pavanda13/Sunflower-Solar-Panel-Controller/assets/outdoor_2.png

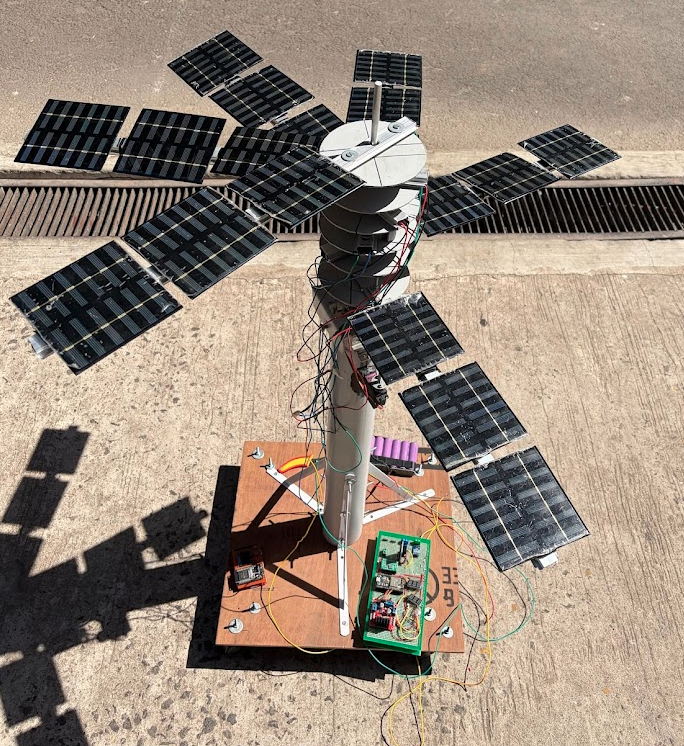
assets/outdoor_2.png
