pavanda13/Sunflower-Solar-Panel-Controller/assets/solar_sunflower_project_2.jpeg

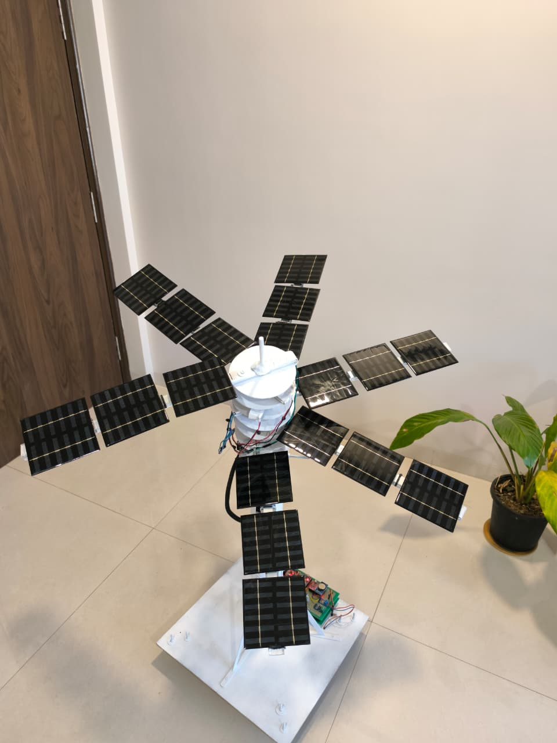
assets/solar_sunflower_project_2.jpeg
