pavanda13/Sunflower-Solar-Panel-Controller/Sunflower_Solar_Controller_Report.docx

SUNFLOWER SOLAR PANEL CONTROLLER

An Intelligent, Autonomous Solar Tracking & Monitoring System

Competition Presentation Report | April 2026

# 1. Introduction

The Sunflower Solar Panel Controller is a two-unit ESP32-based system that mimics the behaviour of a sunflower — deploying a solar panel at sunrise, tracking the sun throughout the day with a servo motor, and retracting the panel safely at sunset. A separate remote unit displays live sensor data on an OLED screen and allows the operator to manually override the servo and DC motor via four physical buttons, all over a private WiFi TCP connection that requires no internet infrastructure.

The project addresses a well-known problem in solar energy: fixed panels lose 25–40% of potential energy because they cannot follow the sun. Commercial solar trackers solve this but cost ₹40,000 or more per unit. This system achieves the same core functionality for under ₹2,500 in components, making professional-grade solar tracking accessible to small farmers, off-grid homes, and developing regions worldwide.

# 2. System Architecture

The system consists of two independent ESP32 microcontroller units that communicate over a private WiFi network using TCP sockets.

## 2.1 Solar Controller (Device 1)

Hardware components and GPIO assignments:

Component | Interface | GPIO Pins
L298N Motor Driver | Digital + PWM | IN1=18, IN2=16, ENA=17
Servo Motor (continuous) | PWM 50 Hz | GPIO 25
Panel Voltage Sensor | ADC | GPIO 34
Panel Current Sensor (ACS712) | ADC | GPIO 35
Battery Voltage Sensor | ADC | GPIO 32
RTC DS3231 | I²C | SDA=13, SCL=14

## 2.2 Remote Control Unit (Device 2)

The remote unit acts as a WiFi Access Point (192.168.4.1:5000). It hosts an OLED 128×64 dashboard showing live panel voltage, current, power, battery voltage, and the current time from the controller's RTC. Four buttons allow manual control:

Button | Command Sent | Command on Release | Effect
Button 1 | SERVO_FWD | SERVO_STOP | Hold to rotate servo forward
Button 2 | SERVO_REV | SERVO_STOP | Hold to rotate servo reverse
Button 3 | PANEL_OPEN | MOTOR_STOP | Hold to open panel manually
Button 4 | PANEL_CLOSE | MOTOR_STOP | Hold to close panel manually

# 3. Communication Protocol

## 3.1 Controller → Remote (every 100 ms)

CSV line over TCP:

HH:MM:SS , voltage , current , power , batteryVoltage

Example: 08:42:15 , 18.34 , 2.10 , 38.51 , 12.67

## 3.2 Remote → Controller (on button press/release)

Command | Trigger | Effect
SERVO_FWD | Hold button 1 | Servo rotates forward — manual sun tracking
SERVO_REV | Hold button 2 | Servo rotates reverse — undo tracking angle
SERVO_STOP | Release button 1 or 2 | Servo stops immediately
PANEL_OPEN | Hold button 3 | Motor opens panel (ignored if not IDLE)
PANEL_CLOSE | Hold button 4 | Motor closes panel (ignored if not IDLE)
MOTOR_STOP | Release button 3 or 4 | Motor stops immediately on release
RESET | Emergency command | Halts everything, clears all state flags

# 4. Key Technical Features

## 4.1 Non-Blocking Architecture

- Main loop runs every 10 ms — never uses delay(). All operations use millis() timers.
- Motor, servo, WiFi reconnect, and sensors all run concurrently without pausing each other.
- WiFi client.connect() is only attempted when motorState == MOTOR_IDLE to prevent blocking the PWM ramp (connect() can stall the CPU for up to 500ms).
- RTC is read over I²C every 1 second and cached — avoids 100× I²C overhead on every 10ms loop iteration.

## 4.2 Motor State Machine

- States: MOTOR_IDLE → MOTOR_OPENING / MOTOR_CLOSING / MOTOR_MANUAL → MOTOR_IDLE
- New commands (schedule or manual) are only accepted when motorState == MOTOR_IDLE, preventing double-trigger.
- The opened/closed flags are set after the motor physically finishes its run — not when the command fires — reflecting real-world panel position.
- Emergency RESET instantly calls hardBrake(), sets motorState = MOTOR_IDLE, and clears all timing variables.

## 4.3 PWM Soft-Ramp Motor Control

- Custom MotorL298N library ramps PWM from 0% → 100% over approximately 5 seconds (1% per 50ms by default).
- A 30% kickstart pulse is applied immediately on setSpeed() to overcome static friction before ramping.
- hardBrake() instantly cuts all PWM and direction pins — used for emergency RESET.
- Smooth ramp significantly reduces mechanical shock, extending the life of the gearbox, belt, and panel mounting hardware.

## 4.4 Automatic Current Sensor Calibration

- On every boot, 500 ADC samples are averaged over 1 second with no load connected.
- The resulting mean voltage is stored as ACS_OFFSET — the zero-current reference.
- This eliminates offset drift caused by temperature changes and supply voltage variation.
- No manual potentiometer or trim adjustment is required — the system self-configures each startup.

## 4.5 Servo Sun Tracking

- Auto-tracking fires every 15 minutes while the panel is open (configurable via SERVO_TRACK_INTERVAL).
- Duration is mathematically calculated from SERVO_RPM and SERVO_TRACK_REVS — not guessed.
- Priority order: Manual command > Auto-track > Stop. Manual override pauses auto-tracking instantly.
- Auto-tracking is cancelled immediately when the panel closes at end of day.

# 5. Large Scale Implementation

## 5.1 Hardware Scaling

- Replace the single ESP32 controller with a Raspberry Pi or industrial PLC as a central hub managing hundreds of panel units over a network.
- The L298N motor driver is replaced with 3-phase motor controllers for the larger DC or AC actuators used in commercial trackers.
- Stepper motors with quadrature encoders replace the continuous-rotation servo, providing precise angular position control and eliminating open-loop drift.
- Industrial-grade CT clamps rated for 100A+ replace the ACS712 modules for high-current installations.
- The OLED display is replaced by a web-based Grafana or React dashboard showing fleet-wide metrics on a map, with per-panel status indicators.
- Dual-axis tracking: a second motor added for elevation angle control increases annual yield by a further 10–15% beyond single-axis.

## 5.2 Network and Software Scaling

- Replace direct TCP with an MQTT broker (Mosquitto). Each panel publishes sensor data to its own topic; a central server subscribes to all topics simultaneously.
- OTA (Over-the-Air) firmware updates push new code to all panels in a field without physical access to each unit.
- Time-series database (InfluxDB or TimescaleDB) stores all sensor readings for historical analysis, fault detection, and energy yield reporting.
- A REST API allows any monitoring tool (mobile app, web browser, SCADA system) to query panel status, issue commands, and update schedules.
- GPS-based sun angle calculation using the NOAA solar position algorithm computes optimal panel angle from latitude, longitude, and UTC time — eliminating the fixed 15-minute interval assumption.
- Cloud backup with automated daily energy yield reports delivered via email or SMS to the owner.

## 5.3 Physical Deployment

- Panels mounted on single-axis tracker rails (east-west rotation) driven by the DC motor — the most common commercial solar tracker design.
- Wind speed sensor auto-retracts all panels when gusts exceed a configurable safe threshold, preventing storm damage.
- IP65-rated weatherproof enclosures for all electronics with cable glands; surge protection and reverse-polarity protection on all power inputs.
- Modular wiring harness — each panel unit is identical and plug-and-play, reducing installation time and training requirements.
- Staggered motor start schedules prevent current surges when all 100+ panels attempt to open simultaneously at sunrise.

# 6. System Improvements

## 6.1 Precision Sun Tracking

- Add an LDR (light-dependent resistor) differential pair — the servo rotates until both sensors read equal illumination, meaning the panel is facing the sun directly. Replaces the open-loop timed pulse.
- Closed-loop position control: rotary encoder on the servo shaft confirms actual angular position and enables the controller to command precise angles rather than timed rotations.
- MPPT algorithm (Maximum Power Point Tracking): continuously adjust panel angle to maximise real-time power output, not just geometric alignment with the sun. Accounts for cloud diffusion and partial shading.
- Add an elevation axis motor for full 2-axis tracking — adds 10–15% annual energy yield over single-axis alone.

## 6.2 Reliability and Safety

- Motor stall detection: add a dedicated current sensor on the motor supply line. A current spike without movement triggers an immediate halt and fault alert.
- Panel position encoder: know the exact open angle at all times. Prevents over-driving the motor if the panel is mechanically obstructed.
- ESP32 hardware watchdog timer: auto-reboots the system if the firmware hangs, ensuring the panel is never left in an unknown state.
- Redundant time source: sync from NTP when WiFi is available; fall back to DS3231 RTC when offline. RTC drift corrected automatically after each NTP sync.
- Surge protection and TVS diodes on all ADC input lines to prevent sensor damage from lightning or motor back-EMF.

## 6.3 Energy Intelligence

- State-of-charge calculation: derive battery percentage from the discharge voltage curve rather than relying on raw voltage alone.
- Watt-hour accumulation: log daily energy yield (kWh) to flash memory for comparison against historical and predicted values.
- Low battery protection: automatically retract the panel and enter sleep mode when battery voltage drops critically low, protecting the battery from deep discharge.
- Efficiency monitoring: compare actual yield to expected yield based on solar irradiance models; alert when efficiency drops more than 10% below threshold (indicating soiling or shading).
- Panel temperature sensor: derate power estimate on hot days (approximately 0.3% per °C above 25°C for silicon cells).

## 6.4 User Interface

- Replace the OLED with a colour TFT touchscreen showing scrollable voltage, current, and power graphs with time-axis.
- Mobile app via Bluetooth or WiFi for configuration: set open/close times, tracking interval, and RPM calibration without touching firmware.
- Push notifications when power drops below expected threshold or a fault is detected — delivered via SMS, WhatsApp, or email.
- Web interface with historical charts, exportable CSV data, and remote schedule configuration accessible from any browser.
- Voice alerts via a small buzzer: distinct tones for open complete, close complete, and fault events.

# 7. Future Benefits and Applications

## 7.1 Energy Independence

- Single-axis tracking increases annual energy yield by 25–40% over a fixed panel installation.
- Adding a second (elevation) axis increases yield by a further 10–15%, for a total gain of up to 55% over fixed.
- More energy from the same number of panels reduces the total hardware cost and land area required for a given power target.
- Longer battery cycle life: the tracker maximises energy extraction during peak sun hours, reducing the number of days the battery must supply energy without solar recharge.

## 7.2 Agrivoltaics (Agriculture + Solar)

- Tilted solar panels allow morning and evening light to reach crops underneath while blocking harsh midday sun.
- Crops grown under tracked panels benefit from reduced heat stress, with studies showing up to 60% less water consumption in some climates.
- Dual income stream: farmers generate and sell electricity while continuing to grow crops on the same land.
- This system's automated tilt angle control makes it a ready-to-use foundation for agrivoltaic installations at the village level.

## 7.3 Smart Grid Integration

- Real-time power data at 100ms resolution feeds directly into grid balancing and demand-response systems.
- When panels report surplus generation, smart switches can automatically divert energy to water heating, EV charging, or grid export.
- Predictive generation forecasting: historical tracking data combined with weather APIs helps grid operators plan backup generation capacity.
- Micro-grid: a cluster of these units with a shared battery bank can power an entire village with automatic load balancing.

## 7.4 Developing World and Disaster Relief

- No internet required — the two ESP32s form their own private WiFi network, deployable in remote areas with zero infrastructure.
- Total BOM cost under ₹2,500 (~$30) makes professional solar tracking accessible to smallholder farmers globally.
- Can be assembled with basic tools and locally available modules — no specialist manufacturing required.
- Portable solar tracker + battery provides uninterrupted power for medical equipment, water pumps, and communications in disaster zones.

## 7.5 Environmental Impact

Scale | Daily Energy Gain vs Fixed | Annual CO₂ Offset
1 rooftop panel (300W) | +~100 Wh/day | ~15 kg CO₂/year
100-panel farm (30 kW) | +~10 kWh/day | ~1,500 kg CO₂/year
Utility-scale (1 MW) | +~350 kWh/day | ~50,000 kg CO₂/year

Based on 35% improvement from single-axis tracking, 300 sunny days/year, and 0.4 kg CO₂/kWh grid average (IEA 2024).

# 8. Competitive Advantages

No Internet Required: The private WiFi network between the two ESP32s works in fields, deserts, and rooftops without any infrastructure. Unlike cloud-dependent systems, it cannot be disrupted by a server outage.

Custom PWM Motor Library: Soft-ramp 0→90% over 5 seconds with kickstart prevents gear shock, motor burnout, and belt snap. No commercial tracker at this price offers configurable ramp control.

Self-Calibrating Sensors: ACS712 zero offset auto-calibrated on every boot with 500 samples — compensates for temperature drift and eliminates manual potentiometer tuning.

State-Machine Safety: Motor only accepts new commands when IDLE. Flags reflect physical panel state, not command state. Single RESET halts everything to a known safe state.

100ms Live Data Stream: 10 readings per second is sufficient to detect transient shadows, partial shading, and wiring faults — far beyond the 1-second resolution of most hobby systems.

Extensible Protocol: Adding a new remote command requires one line in the buttons[] array. No other code changes needed — engineers can extend the system in minutes.

Under ₹2,500 Total Cost: Commercial solar trackers start at ₹40,000+. This system delivers the core functionality for 94% less, making it viable for mass deployment in developing markets.

# 9. Bill of Materials

Component | Qty | Unit Price | Total | Purpose
ESP32 Dev Board | 2 | ₹400 | ₹800 | Controller + Remote unit
L298N Motor Driver | 1 | ₹150 | ₹150 | DC motor control
DC Gear Motor (12V) | 1 | ₹350 | ₹350 | Panel open/close
Continuous Rotation Servo | 1 | ₹280 | ₹280 | Sun tracking
ACS712-30A Current Sensor | 1 | ₹120 | ₹120 | Panel current
Voltage Divider Module | 2 | ₹45 | ₹90 | Panel + battery voltage
DS3231 RTC Module | 1 | ₹180 | ₹180 | Schedule timekeeping
SSD1306 OLED 128×64 | 1 | ₹220 | ₹220 | Live dashboard display
Push Buttons (pack) | 1 | ₹50 | ₹50 | Manual control buttons
Misc (wires, PCB) | 1 | ₹200 | ₹200 | Wiring and prototyping
TOTAL | | | ₹2,440

# 10. Conclusion

The Sunflower Solar Panel Controller demonstrates that intelligent, autonomous solar tracking is not a luxury reserved for large utility companies. With under ₹2,500 of components and carefully engineered firmware, it is possible to build a system that:

- Increases annual solar energy yield by 25–40% through automated sun tracking.
- Monitors real-time panel voltage, current, and power at 100ms resolution.
- Provides a wireless OLED dashboard with live data and manual override — no internet required.
- Uses a robust state-machine architecture that is safe, non-blocking, and extensible.
- Scales directly to large solar farms via MQTT, cloud databases, and OTA firmware updates.
- Saves up to 50,000 kg of CO₂ per year per MW of solar capacity compared to fixed installations.

"The future of solar is not just bigger panels — it is smarter panels that follow the sun, report their health, and respond to their environment automatically."
