pavanda13/Sunflower-Solar-Panel-Controller/Sunflower_Solar_Controller_Presentation.pptx

SUNFLOWER

Solar Panel Controller

An Intelligent, Autonomous Solar Tracking & Monitoring System

Competition Presentation | April 2026

ESP32 • L298N Motor • Servo • RTC • WiFi TCP • OLED

## Slide 2

THE PROBLEM

Why fixed solar panels are not enough

25 – 40%

Energy Lost

Fixed panels miss peak sun because they cannot track the sun's movement across the sky. A panel pointed east loses hours of afternoon output.

Manual Only

No Automation

Repositioning panels by hand is impractical, especially on rooftops, remote farms, or large-scale solar fields with hundreds of panels.

Zero Visibility

No Monitoring

Most DIY systems have no way to know current power output, battery health, or whether the system is working — until something fails.

Weather Damage

No Protection

Panels left fully exposed during storms, hail, or high wind events are at risk of physical damage. Automated retraction prevents this.

High Cost

Barrier to Entry

Commercial solar trackers cost thousands of dollars, making them inaccessible for small farms, rural homes, and developing regions.

No Remote View

Operator Blind

Installers and owners have no remote dashboard to see live voltage, current, and power — making fault diagnosis slow and expensive.

Our system solves all six problems with a single $30 device.

## Slide 3

WHAT THE SYSTEM DOES

Inspired by the sunflower — follows the sun from dawn to dusk

OPEN

Opens panel at sunrise

RTC-scheduled DC motor fires at programmed morning time, physically deploying the solar panel to face the sky.

TRACK

Tracks sun every 15 minutes

Continuous-rotation servo rotates the panel angle toward the sun at 15-minute intervals throughout the day.

CLOSE

Closes panel at sunset

Motor reverses at programmed evening time, retracting the panel to protect it from wind, rain, and vandalism overnight.

MONITOR

Monitors output live

ACS712 current sensor + voltage dividers measure panel voltage (V), current (A), and calculated power (W) every 100 ms.

DISPLAY

Wireless OLED dashboard

A separate ESP32 shows live sensor values on an OLED screen over a private WiFi network — no internet required.

OVERRIDE

Manual control anytime

4 physical buttons let the operator manually open/close the panel or nudge the servo angle at any time.

RESET

Emergency stop

A single RESET command instantly halts motor and servo, clears all state flags — safe for field use.

CALIBRATE

Auto sensor calibration

On every boot, 500 ADC samples are averaged to auto-calibrate the zero-current offset — no manual tuning needed.

## Slide 4

SYSTEM ARCHITECTURE

Two ESP32 units — fully wireless, no internet required

Solar Controller (ESP32 — Client)

▶ L298N DC Motor Driver
▶ Continuous Rotation Servo
▶ Panel Voltage Sensor (GPIO 34)
▶ Panel Current Sensor ACS712 (GPIO 35)
▶ Battery Voltage Sensor (GPIO 32)
▶ RTC DS3231 — I²C timekeeping
▶ WiFi Station mode — TCP client
▶ Non-blocking 10ms loop
▶ PWM soft-ramp motor control
▶ Auto current sensor calibration

Remote Control Unit (ESP32 — AP)

▶ WiFi Access Point (192.168.4.1:5000)
▶ OLED 128×64 live dashboard
▶ Displays: Panel V, Current A, Power W
▶ Displays: Battery V, Time (HH:MM:SS)
▶ Button 1 — SERVO_FWD (hold to run)
▶ Button 2 — SERVO_REV (hold to run)
▶ Button 3 — PANEL_OPEN (hold to run)
▶ Button 4 — PANEL_CLOSE (hold to run)
▶ Auto-reconnects dropped clients
▶ Display refresh every 500ms

◄

WiFi TCP

►

Sensor CSV (100ms)

Button Commands

## Slide 5

KEY TECHNICAL FEATURES

Engineering decisions that make the system reliable in the field

Non-Blocking Architecture

• Main loop runs every 10 ms — never uses delay()
• All operations use millis() timers (motor, servo, WiFi, sensors)
• Motor, servo and WiFi reconnect all run concurrently without pausing each other
• WiFi connect() is only called when motor is IDLE to prevent blocking the PWM ramp

Motor State Machine

• States: MOTOR_IDLE → OPENING / CLOSING / MANUAL → IDLE
• New commands only accepted when state is MOTOR_IDLE — prevents double-trigger
• opened/closed flags set AFTER motor physically finishes — reflects real world
• Emergency RESET command instantly halts motor, servo, and clears all flags

PWM Soft-Ramp Control

• Custom MotorL298N library ramps 0→90% over ~5 seconds
• 30% kickstart PWM prevents stall against static friction on startup
• hardBrake() instantly cuts all PWM — used during RESET
• Smooth ramp reduces mechanical shock, extends belt and gear life significantly

Automatic Sensor Calibration

• ACS712 zero-current offset auto-calibrated on every boot
• Averages 500 ADC samples over 1 second before accepting load
• Eliminates offset drift from temperature and supply voltage variation
• No manual potentiometer tuning required — works out of the box

Servo Sun Tracking

• Auto-tracking fires every 15 minutes while panel is open
• Duration calculated from RPM and revolutions (not guessed)
• Manual override has highest priority — auto-track pauses instantly
• Tracking cancelled automatically when panel closes at end of day

Data Transmission

• CSV sent over TCP every 100 ms: time, V, A, W, battery V
• RTC cached every 1 second — avoids I²C overhead every 10 ms loop
• WiFi auto-reconnects every 5 seconds if connection drops
• Button press edge-detected with 200 ms debounce; release is immediate

## Slide 6

COMMUNICATION PROTOCOL

Private WiFi — TCP — no cloud, no internet, no latency

Controller → Remote (every 100 ms)

Format: HH:MM:SS , voltage , current , power , batteryVoltage

Example: 08:42:15 , 18.34 , 2.10 , 38.51 , 12.67

Field

Unit

Source

HH:MM:SS

voltage

Time

V

DS3231 RTC

Panel voltage divider GPIO 34

current

power

A

W

ACS712 current sensor GPIO 35

Calculated: voltage × current

Remote → Controller (on button press/release)

batteryVoltage

V

Battery voltage divider GPIO 32

Command

SERVO_FWD

Trigger

Hold button 1

Effect

Servo rotates forward — manual sun tracking

SERVO_REV

SERVO_STOP

Hold button 2

Release button 1 or 2

Servo rotates reverse — undo tracking angle

Servo stops immediately on release

PANEL_OPEN

PANEL_CLOSE

MOTOR_STOP

Hold button 3

Hold button 4

Release button 3 or 4

DC motor opens panel (only if MOTOR_IDLE)

DC motor closes panel (only if MOTOR_IDLE)

Motor stops immediately on release

RESET

Emergency

Halts everything, clears all state flags

## Slide 7

LARGE SCALE IMPLEMENTATION

How this prototype scales to a commercial solar farm

Hardware Scaling

• Replace ESP32 with Raspberry Pi / industrial PLC as central hub
• L298N → 3-phase motor controllers for larger actuators
• Single servo → stepper motors with encoders for precise angular control
• Voltage dividers → industrial CT clamps rated for high currents (100A+)
• OLED → web-based Grafana/React dashboard for fleet-wide metrics
• Add dual-axis trackers: separate motor for elevation angle control

Network & Software Scaling

• Replace direct TCP with MQTT broker (Mosquitto) — each panel is a topic
• OTA (Over-the-Air) firmware updates across entire field without physical access
• Time-series database (InfluxDB / TimescaleDB) for historical analysis
• REST API so any device (phone, browser, SCADA) can query panel status
• GPS-based sun angle calculation from latitude/longitude using NOAA formulas
• Cloud backup with daily energy yield reports sent via email/SMS

Physical Deployment

• Single-axis tracker (east-west) driven by DC motor — most common commercial design
• Dual-axis tracker adds elevation control for maximum annual yield
• Wind speed sensor auto-retracts all panels when gusts exceed safe threshold
• IP65 weatherproof enclosures for all electronics; surge protection on sensors
• Modular wiring harness — each panel unit is identical, plug-and-play
• Remote diagnostic port: plug in laptop to pull logs without disassembly

Operations at Scale

• Central dashboard shows all panels on a map — green/amber/red status
• Predictive maintenance: compare daily yield to expected yield, flag underperformers
• Automated fault detection: if panel V drops unexpectedly, send SMS alert
• Staggered motor schedules to avoid current surge when 100 panels open at once
• Role-based access: operators can view, admins can reconfigure schedules
• Audit log of all commands and state changes for insurance and warranty claims

## Slide 8

SYSTEM IMPROVEMENTS

Upgrades to transform the prototype into a production-grade system

Precision Sun Tracking

• Add LDR (light-dependent resistor) pair — servo stops when both read equal light
• Closed-loop: encoder on servo shaft confirms actual angular position
• MPPT algorithm — track angle that maximises real-time power, not just sun direction
• Add elevation axis motor for full 2-axis tracking (+15% extra yield over single axis)
• Store tracking history to learn seasonal patterns and anticipate sun position

Reliability & Safety

• Motor stall detection — dedicated current sensor on motor supply line
• Panel position encoder — know exact open angle, prevent over-driving
• ESP32 hardware watchdog — auto-reboot if firmware hangs
• Redundant NTP time sync when WiFi is available; RTC as offline fallback
• Surge protection and reverse-polarity protection on all power inputs

Energy Intelligence

• State-of-charge calculation from battery voltage discharge curve
• Watt-hour accumulation — log daily energy yield (kWh) to flash memory
• Low battery alert — automatically retract panel and go to sleep mode
• Compare actual vs expected yield — alert if efficiency drops below threshold
• Temperature sensor on panel — derate power estimate on hot days (3% per °C)

User Interface

• Replace OLED with colour TFT touchscreen showing voltage/current/power graphs
• Mobile app via Bluetooth for configuration (set open/close times, tracking interval)
• Push notifications when power drops below expected or a fault is detected
• Voice alerts via small buzzer — different tones for open, close, fault events
• Web interface with historical charts, exportable CSV, and remote schedule config

Connectivity

• MQTT over WiFi to a local home server or cloud broker (AWS IoT / HiveMQ)
• LoRa radio fallback for installations beyond WiFi range (up to 10km line-of-sight)
• 4G LTE module option for completely off-grid sites with no WiFi infrastructure
• Mesh networking — controllers relay data through each other to the gateway
• Encrypted TLS communication to prevent command injection over the air

Manufacturing & Deployment

• Custom PCB to replace breadboard wiring — reduces failure points significantly
• Conformal coating on PCB for humidity and corrosion resistance
• 3D-printed weatherproof enclosure with cable glands and DIN rail mount
• Factory calibration routine — automated test jig checks each unit before shipping
• QR code on each unit links to its data dashboard and service history

## Slide 9

FUTURE BENEFITS & APPLICATIONS

Why this technology matters beyond the competition

Energy Independence

• Single-axis tracker increases annual yield by 25–40% over fixed panels
• Dual-axis tracking adds a further 10–15% on top of single-axis
• Fewer panels needed for the same power target — lower land and material cost
• Longer battery cycle life: tracker extracts full energy during peak sun hours
• Enables off-grid homes, farms, and villages to become energy self-sufficient

Agricultural (Agrivoltaics)

• Tilted panels let morning/evening light through while blocking harsh midday sun
• Crops grown underneath benefit from shade — up to 60% less water consumption
• Dual income: farmers sell electricity AND grow crops on the same land
• This system’s tilt angle control makes it a ready foundation for agrivoltaics
• Already deployed at scale in Japan, Germany, and South Korea

Smart Grid Integration

• Real-time power data at 100ms resolution feeds directly into grid balancing
• When panels report excess generation, smart switches divert energy to EV charging
• Demand-response: utilities can remotely schedule open/close times to shift load
• Micro-grid: cluster of these units can power a village with automatic load sharing
• Predictive generation forecast helps grid operators plan backup generation

Developing World & Disaster Relief

• No internet required — the two ESP32s form their own private WiFi network
• Total BOM cost under ₹2500 (∼$30) — accessible to smallholder farmers globally
• Can be assembled with basic tools and locally available components
• Solar tracker + battery means uninterrupted power even in remote locations
• Deployed to disaster zones as portable power stations for medical equipment

Environmental Impact

• Every 1% yield improvement = proportionally fewer panels for a given power target
• Fewer panels = less silicon, aluminium, and rare earth mining required
• 1 MW solar farm with tracking: +350 kWh/day = saves ~50,000 kg CO₂/year
• Retractable panels survive hailstorms — longer panel life, less e-waste
• Closed-loop MPPT maximises green energy extraction without any fuel burning

Commercial & Research Opportunities

• Platform for AI-based sun prediction using historical tracking data
• University research tool for studying panel degradation and soiling effects
• Integration with weather APIs to pre-position panels before storms arrive
• Data marketplace: anonymised energy yield data valuable to grid planners
• White-label product for solar installation companies to brand and resell

## Slide 10

REAL-WORLD IMPACT

Quantified energy gains from single-axis solar tracking

+35%

Average annual energy gain
from single-axis tracking
vs fixed panel

+50%

Peak-hour energy gain
on clear summer days

100ms

Sensor data refresh rate
— real-time monitoring
for every panel

₹2500

Total Bill of Materials
cost for the complete
two-unit system

15 min

Sun tracking interval
— optimal balance of
yield vs servo wear

50,000 kg

CO₂ saved per year
for a 1 MW farm
using this tracker

Based on 35% improvement from single-axis tracking, 300 sunny days/year, 0.4 kg CO₂/kWh grid average (IEA 2024)

## Slide 11

COMPETITIVE ADVANTAGES

What makes this system stand out

No Internet Required

The two ESP32s form a private WiFi network. Works in fields, deserts, rooftops — anywhere with no infrastructure. Unlike cloud-dependent systems, it cannot be killed by a server outage.

Custom PWM Motor Library

Soft-ramp 0→90% over 5 seconds with kickstart — prevents gear shock, motor burnout, and belt snap. No commercial tracker at this price point offers configurable ramp control.

01

02

Self-Calibrating Sensors

ACS712 zero offset auto-calibrated on every boot with 500 samples. Eliminates manual potentiometer tuning and compensates for temperature drift automatically over the lifetime of the unit.

03

State-Machine Safety

Motor only accepts a new command when IDLE — impossible to trigger opening while already opening. Flags are set after physical completion, not on command issue, reflecting real-world state.

04

100ms Live Data Stream

10 readings per second over TCP gives a smooth, real-time view of voltage, current, and power. Enough resolution to detect transient shadows, partial shading, and wiring faults.

05

Extensible Command Protocol

Adding a new button or remote command requires one line in the buttons[] array — no other code changes. Engineers can add features in minutes without understanding the full codebase.

06

Emergency Reset

A single RESET command stops motor, stops servo, clears all flags and timers instantly. Designed for field safety — operator presses one button and the entire system is in a known safe state.

07

Under ₹2500 Total Cost

Complete two-unit system costs under ₹2500 using off-the-shelf modules. Commercial solar trackers start at ₹40,000+. This makes professional-grade tracking accessible to small farmers globally.

08

## Slide 12

BILL OF MATERIALS

Complete hardware cost — under ₹2500 for the full system

Component

ESP32 Dev Board

Qty

2

Unit Price

₹400

Total

₹800

Purpose

Main controller + Remote control unit

L298N Motor Driver Module

1

₹150

₹150

DC motor direction and PWM speed control

DC Gear Motor (12V)

Continuous Rotation Servo

1

1

₹350

₹280

₹350

₹280

Opens and closes the solar panel

Sun tracking axis rotation

ACS712-30A Current Sensor

1

₹120

₹120

Panel output current measurement

Voltage Divider Module

DS3231 RTC Module

2

1

₹45

₹180

₹90

₹180

Panel voltage + battery voltage sensing

Real-time clock for open/close scheduling

SSD1306 OLED 128×64

1

₹220

₹220

Live sensor dashboard on remote unit

Push Buttons (pack)

1

₹50

₹50

4 control buttons on remote unit

Miscellaneous (wires etc)

TOTAL

1

₹200

₹200

₹2,440

Jumper wires, breadboard, capacitors, resistors

## Slide 13

CONCLUSION

1. Low-cost hardware, professional results

Under ₹2500 of components delivers intelligent, autonomous solar tracking — capabilities previously only available in ₹40,000+ commercial systems.

2. Non-blocking, state-machine firmware

Motor, servo, WiFi, and sensors all run concurrently on a single microcontroller. The software architecture is sound enough to scale to production.

3. Wireless and self-contained

No internet, no cloud, no single point of failure. The two-unit system forms its own private network — deployable anywhere on Earth.

4. Clear upgrade path

LDR closed-loop tracking, MPPT, MQTT, OTA updates, custom PCB — every improvement is well-defined and builds directly on the existing architecture.

5. Measurable real-world impact

+35% annual energy yield, 50,000 kg CO₂ saved per MW, and a ₹2500 price point that makes solar tracking accessible to smallholder farmers worldwide.

"The future of solar is not just bigger panels — it is smarter panels that follow the sun, report their health, and respond to their environment automatically."
