pavanda13/Sunflower-Solar-Panel-Controller/assets/circuit_diagram.png

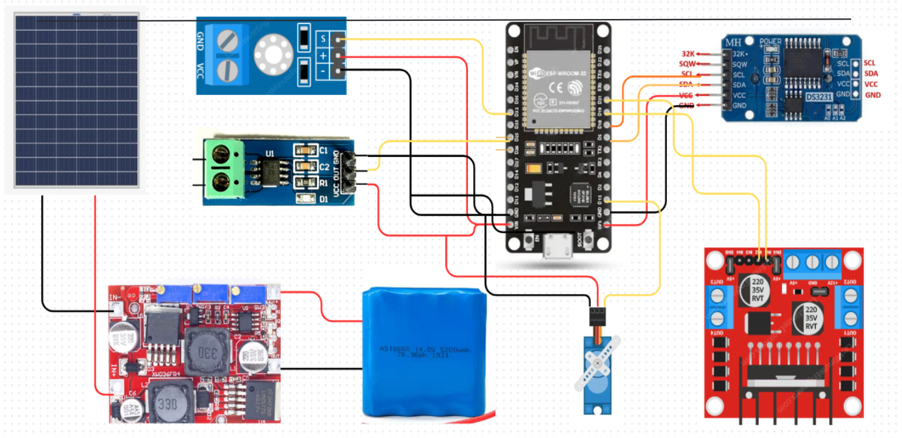
assets/circuit_diagram.png
