pavanda13/Sunflower-Solar-Panel-Controller/assets/outdoor_1.png

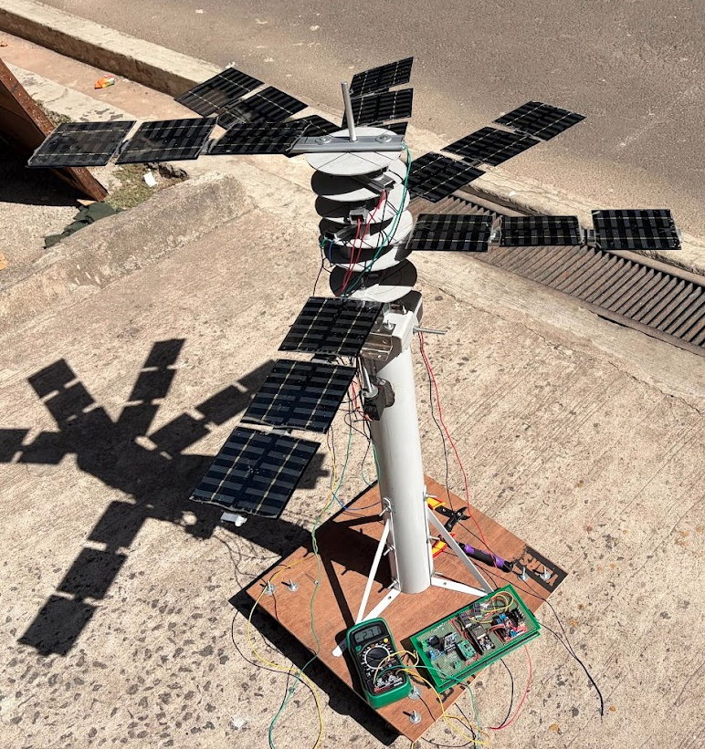
assets/outdoor_1.png
