pavanda13/Sunflower-Solar-Panel-Controller/assets/outdoor_top_view.png

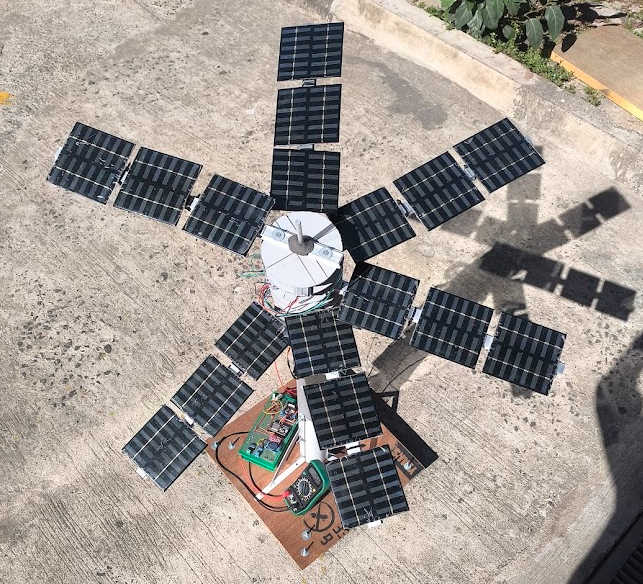
assets/outdoor_top_view.png
