pavanda13/Sunflower-Solar-Panel-Controller/assets/solar_sunflower_project_1.jpeg

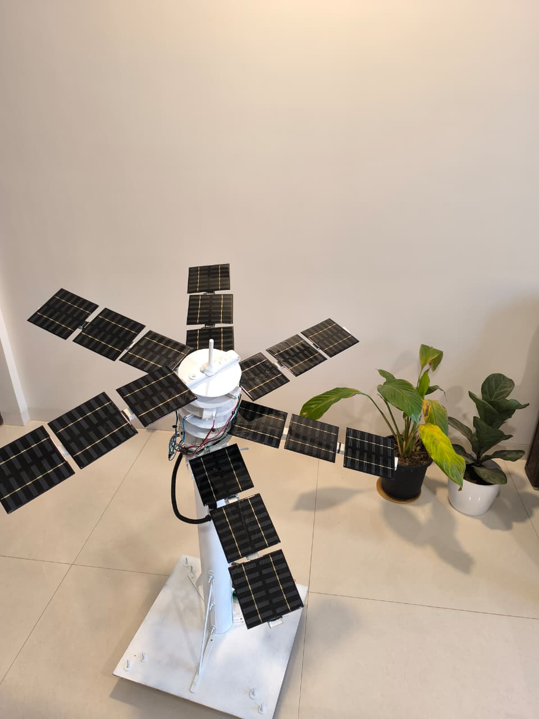
assets/solar_sunflower_project_1.jpeg
