pavanda13/Sunflower-Solar-Panel-Controller/(commit log)

2026-04-15 Initial commit: ESP32 solar controller with servo and L298N motor control
2026-04-15 Fix motor missed-start caused by WiFi connect() blocking, improve MotorL298N
    [MotorL298N.h, SOLAR_CONREOLLER.ino]
2026-04-15 Change servo pin to GPIO 25, reduce open/close duration to 4s
2026-04-16 Add manual DC motor control via MOTOR_FWD / MOTOR_REV / MOTOR_STOP commands
2026-04-16 Add 4-button control, PANEL_TOGGLE/OPEN/CLOSE/RESET handlers, fix debounce
    [SOLAR_CONREOLLER.ino, controller_unit.ino]
2026-04-16 Hold-to-run buttons: press starts, release stops motor and servo
2026-04-17 Fix scheduled motor run being overridden by manual button commands
    PANEL_OPEN/PANEL_CLOSE now only accepted when MOTOR_IDLE, preventing
    spurious or buffered commands from hijacking a running scheduled
    MOTOR_OPENING/MOTOR_CLOSING operation and zeroing motorStopAt.
    MOTOR_STOP uses soft stop instead of hardBrake on manual release.
    [SOLAR_CONREOLLER.ino]
2026-04-17 Add competition presentation and report
    Generates a 13-slide PowerPoint (dark navy/amber theme) and a 10-section
    Word report covering system overview, architecture, key technical features,
    large-scale implementation, improvements, future benefits, impact stats,
    competitive advantages, and BOM. Includes the generate_presentation.py script.
2026-05-16 Add Streamlit project website with 19 sections, scroll animations, and rich content
    - Full Streamlit app (app.py) presenting the Solar Sunflower Controller project
    - 19 sections: Introduction, Problem Statement, Proposed Solution, What The System
    Does, System Architecture, Circuit Diagram, Technical Stack, Communication
    Protocol, Key Technical Features, Innovation Factor, Implementation & Testing,
    Testing Results, Large Scale Implementation, System Improvements, Future
    Benefits, Real-World Impact, Competitive Advantages, Conclusion, Gallery
    - CSS grid architecture diagram replacing ASCII art; split st.markdown calls to
    fix raw HTML rendering in Communication Protocol and Circuit Di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
    [app.py]
2026-05-16 fix: auto start issue
    [SOLAR_CONREOLLER.ino, controller_unit.ino]
